TangatBaktybergen/Gameboy/design/pcb.png

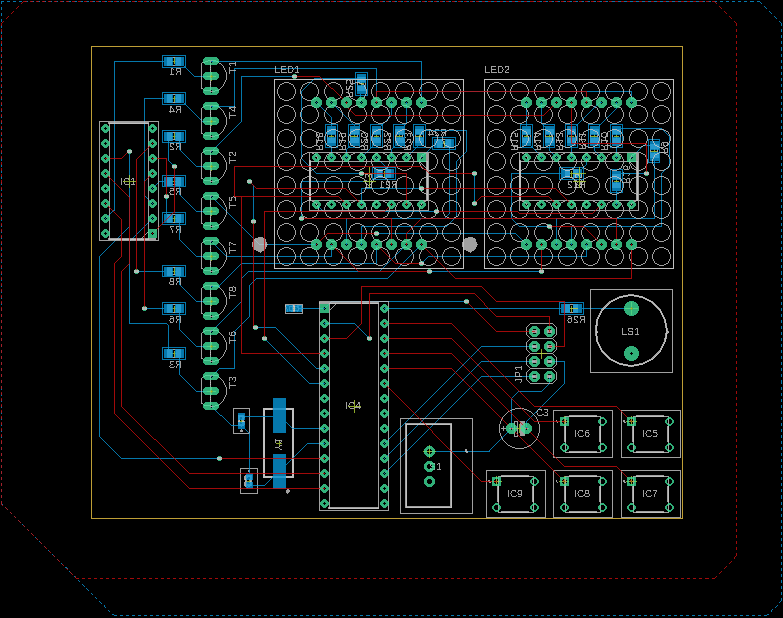
design/pcb.png
