TangatBaktybergen/Gameboy/design/schematics.png

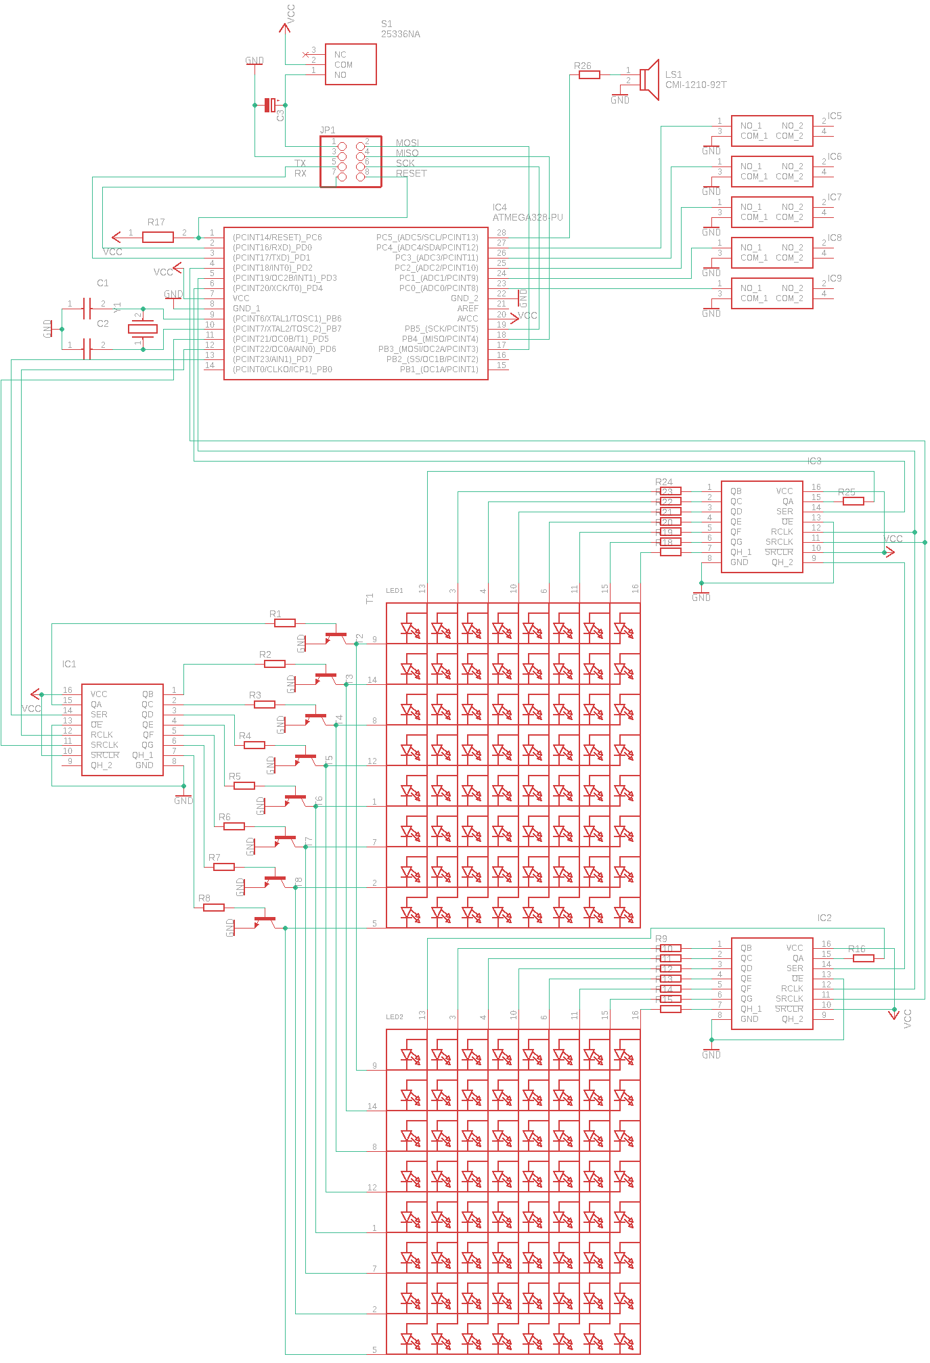
design/schematics.png
