TangatBaktybergen/Gameboy/resources/atmegaconn.png

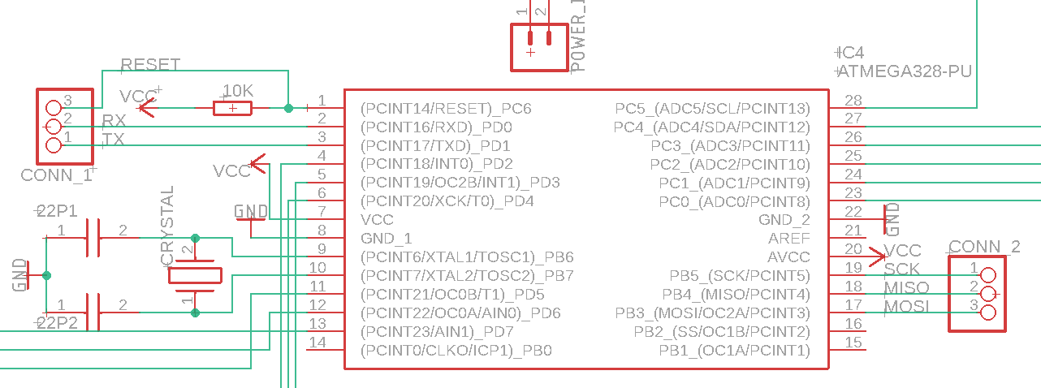
resources/atmegaconn.png
