TangatBaktybergen/Gameboy/(commit log)

2023-01-09 Upload front pcb
2023-01-09 Upload pcb bottom
